InisUAP/mulita/Manual mulita  - MANUAL DE ARMADO - vd.pdf

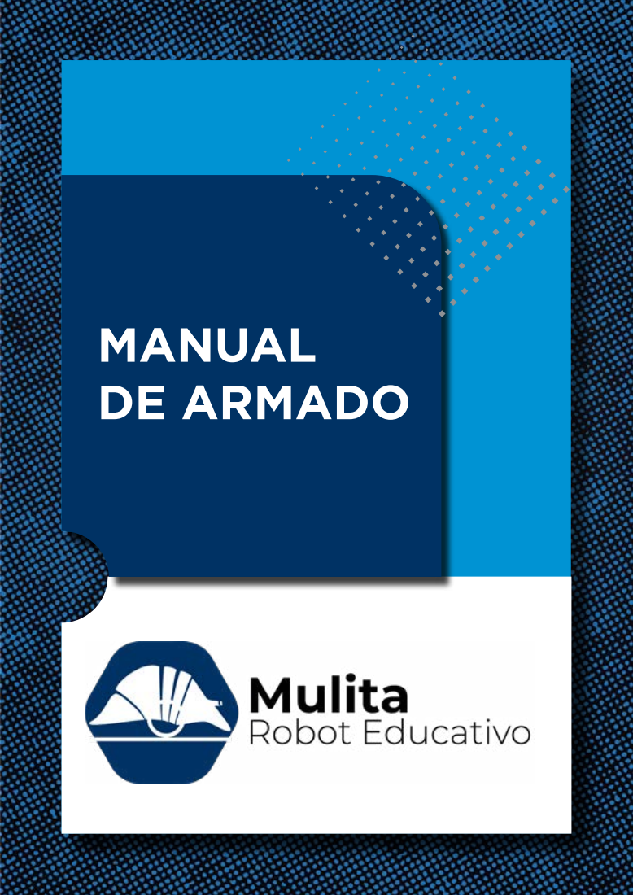
[picture p52: page 1]
MANUAL DE ARMADO

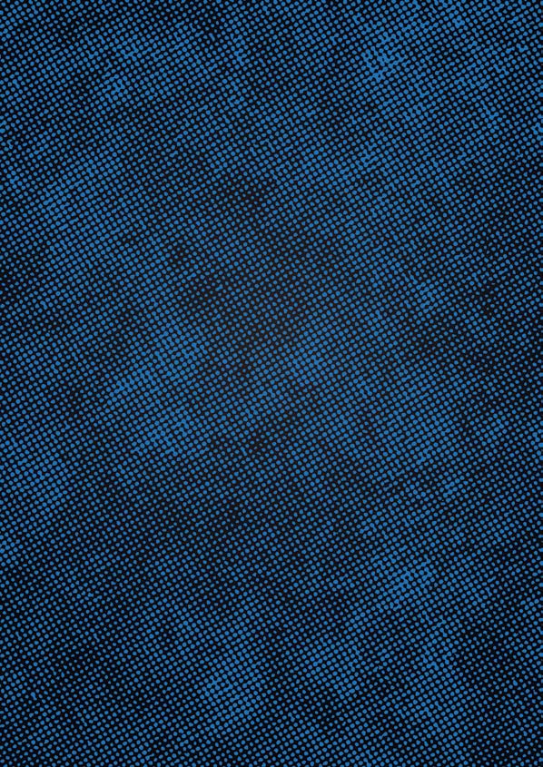
[picture p53: page 2]
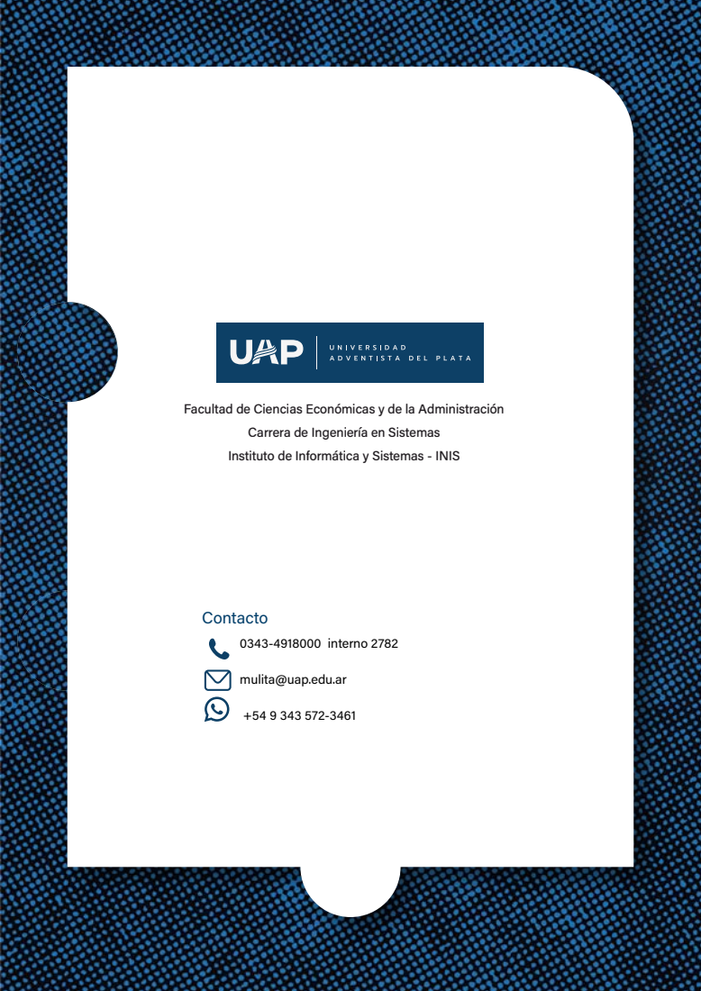
[picture p54: page 3]
0343-4918000 interno 2782; Contacto

Facultad de Ciencias Económicas y de la Administración

Carrera de Ingeniería en Sistemas

Instituto de Informática y Sistemas - INIS

mulita@uap.edu.ar

Autor: Sebastián Javier Calderón Diseño del manual: Mariel Mambretti Copyright y licencias
Mulita y logo de Mulita
Marcas/Trademarks
Atmel® and AVR® are registered trademarks or trademarks of Atmel Corporation or its subsidiaries, in theUS and/or other countries.
Arduino and Arduino UNO
Fritzing
miniBloq
Otros productos, nombres de firmas o empresas, marcas o brand names son marcas registradas o trademarks de sus respectivos propietarios. Cualquier omisión es no intencional.
Descargo de responsabilidad/Disclaimer:
La editorial y el autor hacen el mayor esfuerzo posible por garantizar la exactitud de la información presentada en este documento. Sin embargo, ni la editorial ni el autor se responsabilizan por los errores o las inexactitudes que pudieran aparecer. La información contenida en este documento está sujeta a cambios sin previo aviso. Todos los productos, marcas y nombres de firmas o empresas mencionados en este documento son propiedad exclusiva de sus respectivos propietarios. Cualquier omisión o error es absolutamente no intencional.
Este trabajo, el software o los elementos que eventualmente lo acompañen (sean estos de cualquier clase) son provistos por los dueños de los derechos intelectuales y por quienes contribuyeron a su desarrollo “como son”, renunciando ellos a cualquier tipo de garantía explícita o implícita, incluyendo, aunque no limitándose, a las garantías implícitas de comercialización y de adaptación a propósitos particulares. Bajo ninguna circunstancia serán los dueños de los derechos intelectuales y quienes contribuyeron al desarrollo responsables por daño alguno, directo, indirecto, incidental, casual, causal (incluyendo pero no limitándose a daños a la vida y/o a la propiedad, pérdida de datos, lucro cesante, interrupción de negocios), aunque este ocurra bajo cualquier teoría de derecho, producido en cualquier forma de uso de este desarrollo o desarrollos de él derivados, aun cuando se avise o no de dicho daño o su posibilidad.

# ÍNDICE

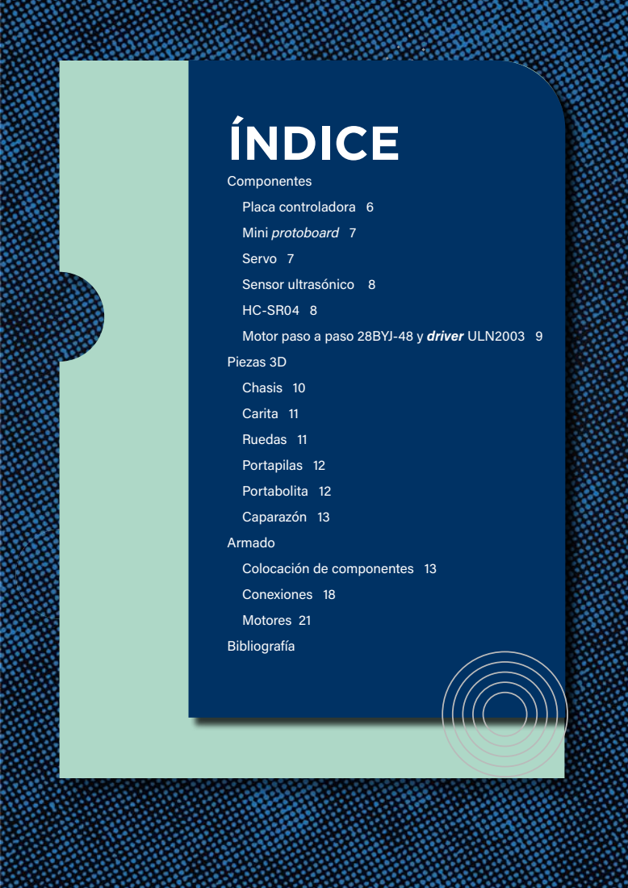
[picture p55: page 5]
Componentes Placa controladora 6 Mini protoboard 7 Servo 7 Sensor ultrasónico 8 HC-SR04 8 Motor paso a paso 28BYJ-48 y driver ULN2003 9 Piezas 3D Chasis 10 Carita 11 Ruedas 11 Portapilas 12 Portabolita 12 Caparazón 13 Armado Colocación de componentes 13 Conexiones 18 Motores 21 Bibliografía

Manual de armado Mulita

### La Mulita está conformada por cinco componentes básicos entre los que se encuentran la placa controladora, los motores y los sensores para la funcionalidad básica del

robot.

# COMPONENTES

La Mulita utiliza una placa controladora ArduinoUNO, que es la mejor placa para iniciar con la programación y la electrónica. Si es tu primera experiencia con la plataforma Arduino, la ArduinoUNO es la opción más robusta, más usada y con mayor cantidad de documentación de toda la familia Arduino.

# Placa controladora

Fuente: elaboración propia
6

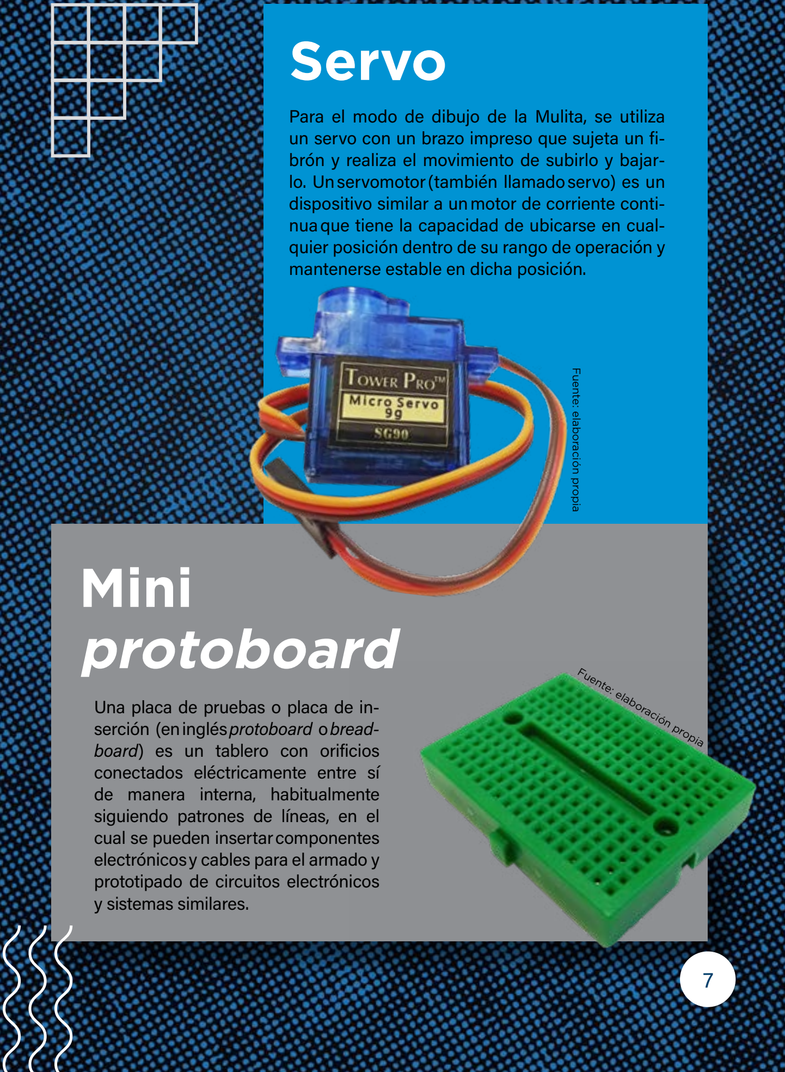
[picture p56: figure]
lo. Unservomotor(también llamadoservo) es un; mantenerse estable en dicha posición.; Servo; Una placa de pruebas o placa de in- serción (eninglésprotoboard obread- board) es un tablero con orificios conectados eléctricamente entre sí de manera interna, habitualmente siguiendo patrones de líneas, en el cual se pueden insertarcomponentes electrónicosy cables para el armado y prototipado de circuitos electrónicos y sistemas similares.; Mini

Para el modo de dibujo de la Mulita, se utiliza un servo con un brazo impreso que sujeta un fibrón y realiza el movimiento de subirlo y bajar-

dispositivo similar a unmotor de corriente continuaque tiene la capacidad de ubicarse en cualquier posición dentro de su rango de operación y

protoboard | Fuente: elaboración propia Fuente: elaboración propia

# Sensor ultrasónico

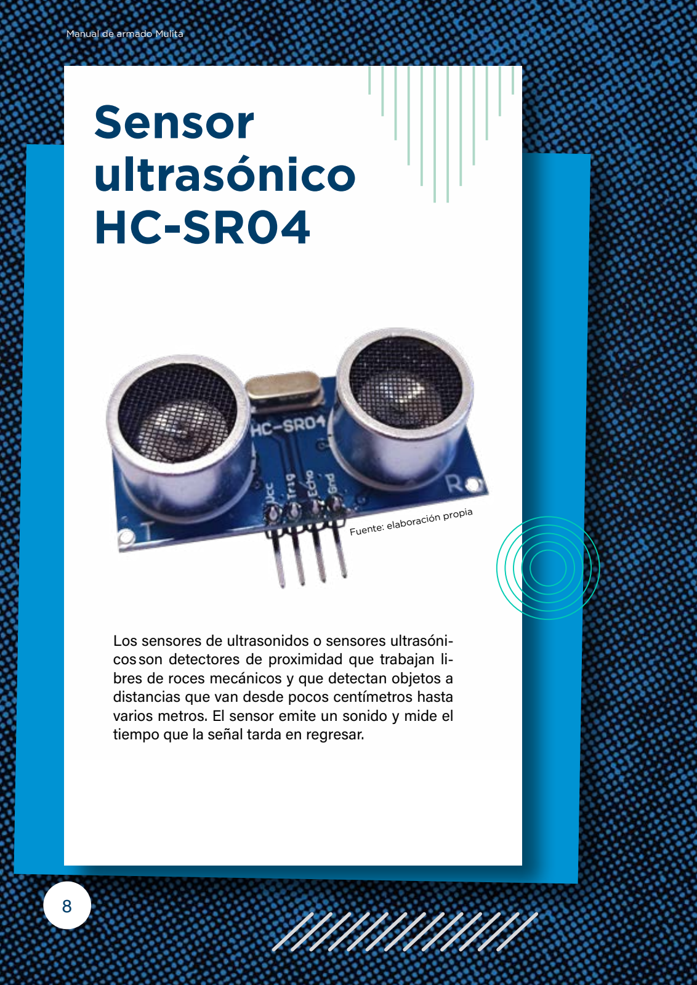
[picture p57: page 8]

Los sensores de ultrasonidos o sensores ultrasónicos son detectores de proximidad que trabajan libres de roces mecánicos y que detectan objetos a distancias que van desde pocos centímetros hasta varios metros. El sensor emite un sonido y mide el tiempo que la señal tarda en regresar.

Fuente: elaboración propia

# HC-SR04

8

# Motor paso a paso 28BYJ-48 y driver

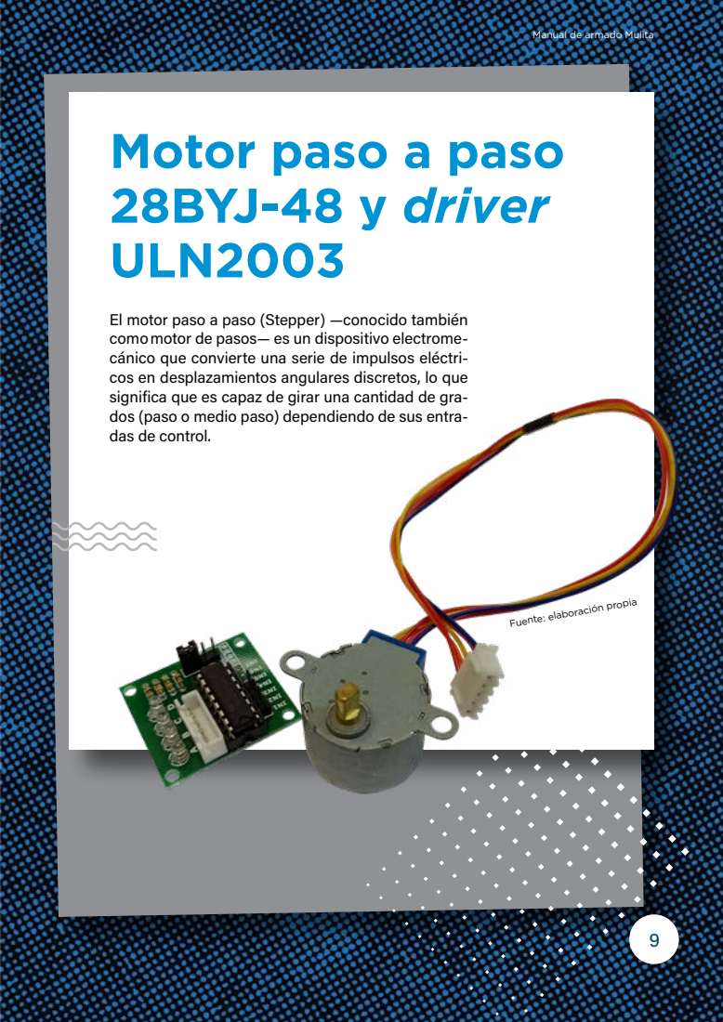
[picture p58: page 9]
ULN2003

El motor paso a paso (Stepper) —conocido también
comomotor de pasos— es un dispositivo electrome-
cánico que convierte una serie de impulsos eléctri-
cos en desplazamientos angulares discretos, lo que
significa que es capaz de girar una cantidad de gra-
dos (paso o medio paso) dependiendo de sus entra-
das de control.

Fuente: elaboración propia

# PIEZAS 3D

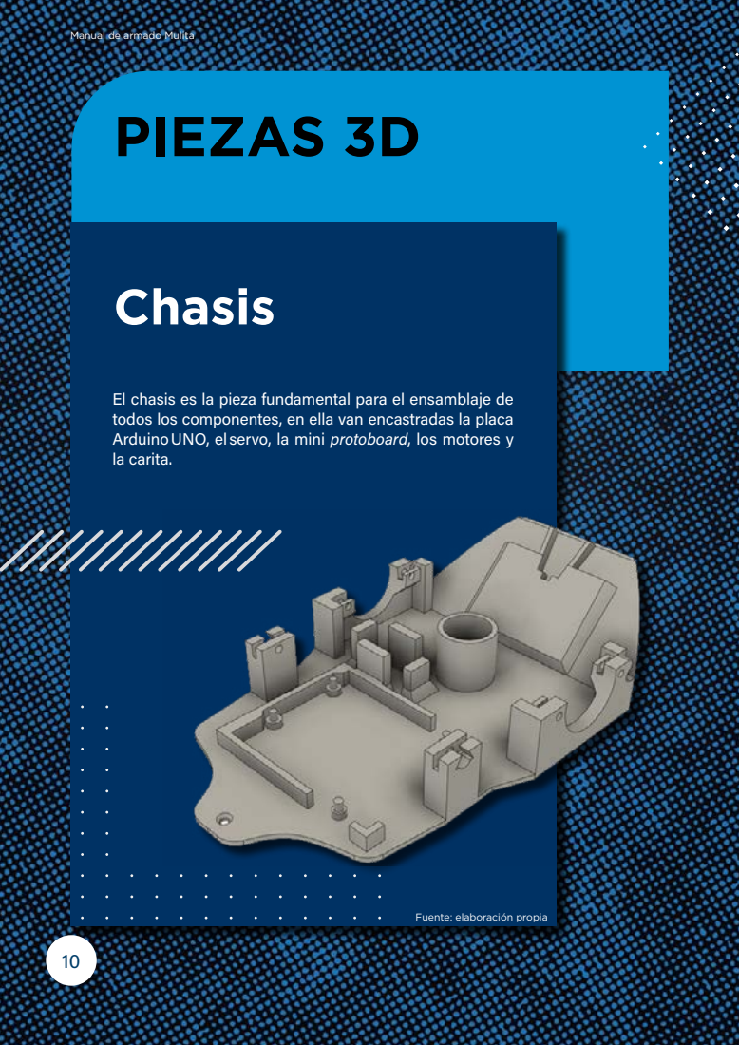
[picture p59: page 10]
Chasis

El chasis es la pieza fundamental para el ensamblaje de
todos los componentes, en ella van encastradas la placa
ArduinoUNO, el servo, la mini protoboard, los motores y
la carita.

Fuente: elaboración propia

# Ruedas

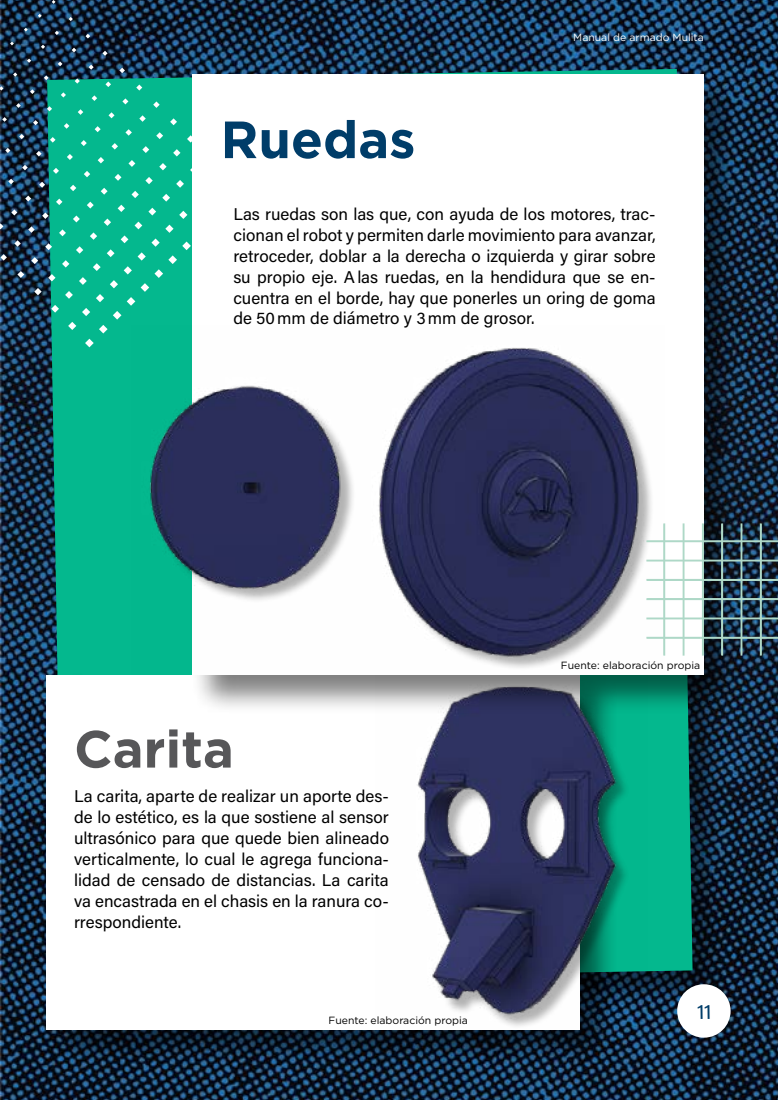
[picture p60: page 11]
Carita; Fuente: elaboración propia

Las ruedas son las que, con ayuda de los motores, trac-
cionan el robot y permiten darle movimiento para avanzar,
retroceder, doblar a la derecha o izquierda y girar sobre
su propio eje. Alas ruedas, en la hendidura que se en-
cuentra en el borde, hay que ponerles un oring de goma
de 50mm de diámetro y 3mm de grosor.

Fuente: elaboración propia

La carita, aparte de realizar un aporte des-
de lo estético, es la que sostiene al sensor
ultrasónico para que quede bien alineado
verticalmente, lo cual le agrega funciona-
lidad de censado de distancias. La carita
va encastrada en el chasis en la ranura co-
rrespondiente.

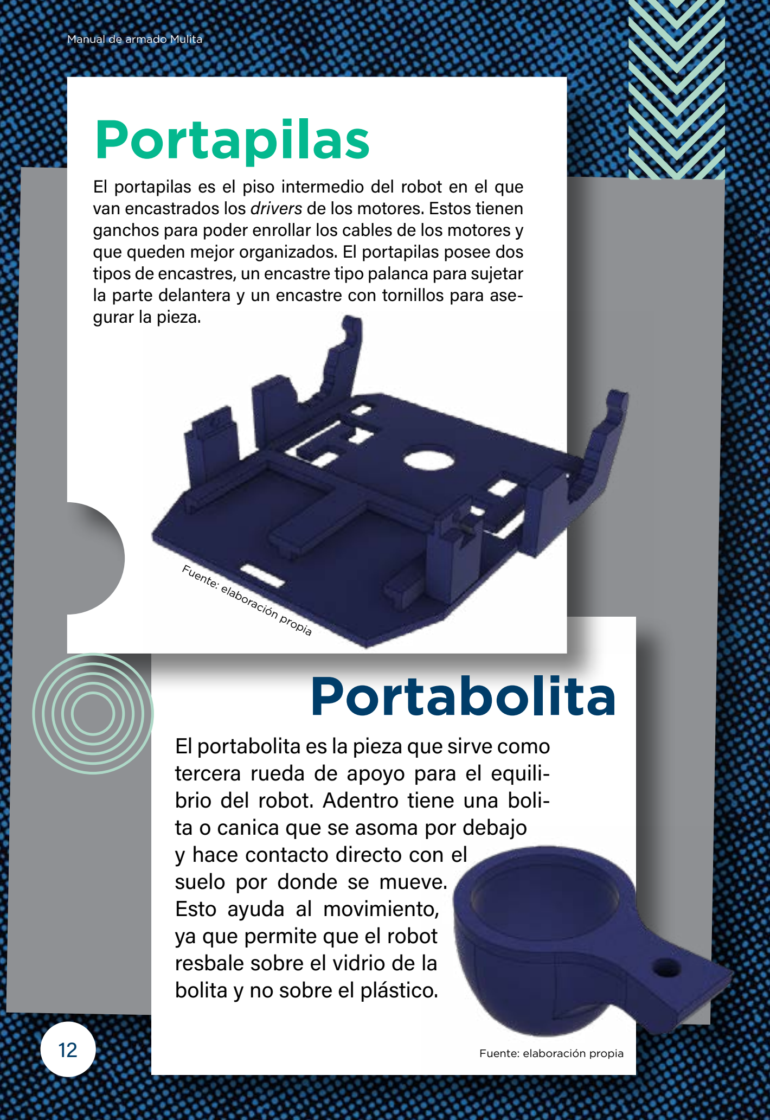
[picture p61: figure]
Portapilas; Fuente: elaboración propia; tercera rueda de apoyo para el equili- brio del robot. Adentro tiene una boli- ta o canica que se asoma por debajo y hace contacto directo con el suelo por donde se mueve. Esto ayuda al movimiento, ya que permite que el robot resbale sobre el vidrio de la bolita y no sobre el plástico.; Portabolita; gurar la pieza.

### El portabolita es la pieza que sirve como

El portapilas es el piso intermedio del robot en el que van encastrados los drivers de los motores. Estos tienen ganchos para poder enrollar los cables de los motores y que queden mejor organizados. El portapilas posee dos tipos de encastres, un encastre tipo palanca para sujetar la parte delantera y un encastre con tornillos para ase-

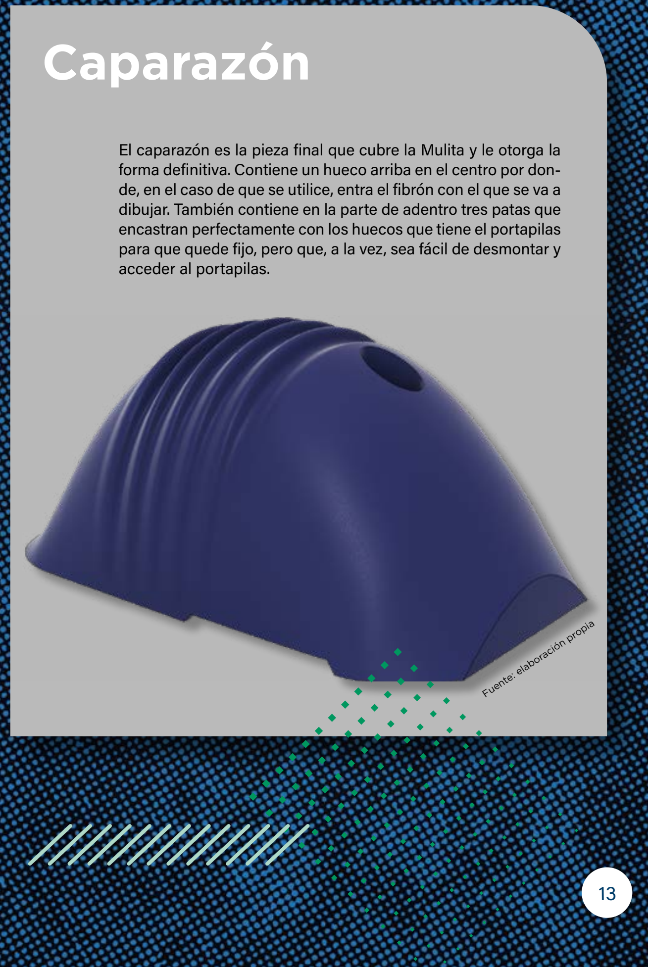
[picture p62: figure]
acceder al portapilas.; Caparazón; Fuente: elaboración propia

El caparazón es la pieza final que cubre la Mulita y le otorga la forma definitiva. Contiene un hueco arriba en el centro por donde, en el caso de que se utilice, entra el fibrón con el que se va a dibujar. También contiene en la parte de adentro tres patas que encastran perfectamente con los huecos que tiene el portapilas para que quede fijo, pero que, a la vez, sea fácil de desmontar y

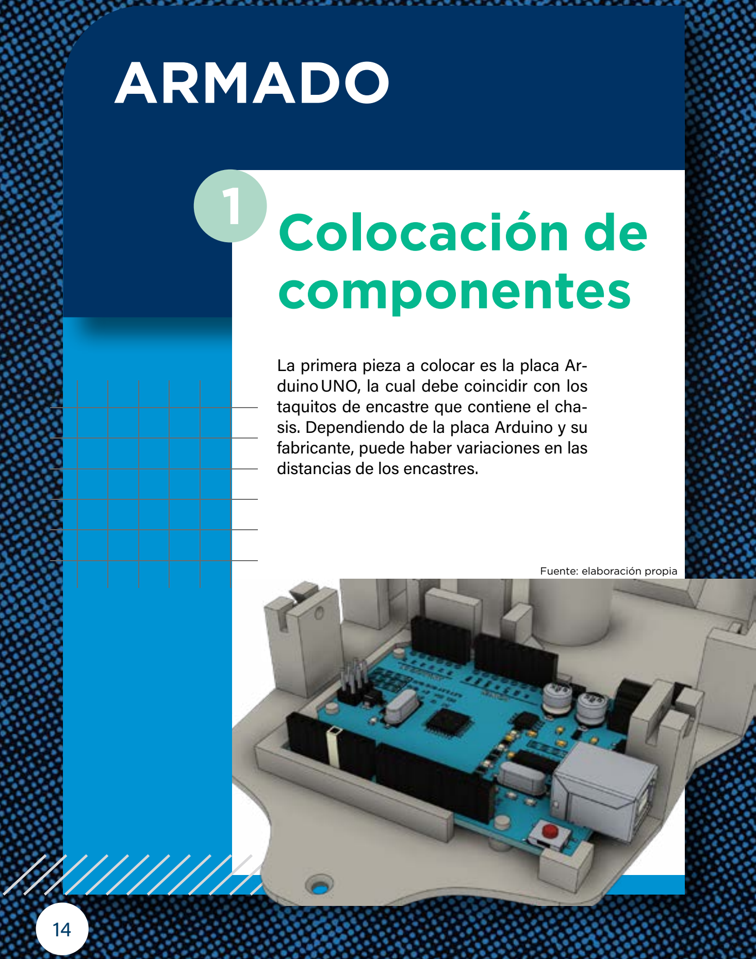
[picture p63: figure]
ARMADO; Colocación de componentes; distancias de los encastres.; Fuente: elaboración propia

La primera pieza a colocar es la placa ArduinoUNO, la cual debe coincidir con los taquitos de encastre que contiene el chasis. Dependiendo de la placa Arduino y su fabricante, puede haber variaciones en las

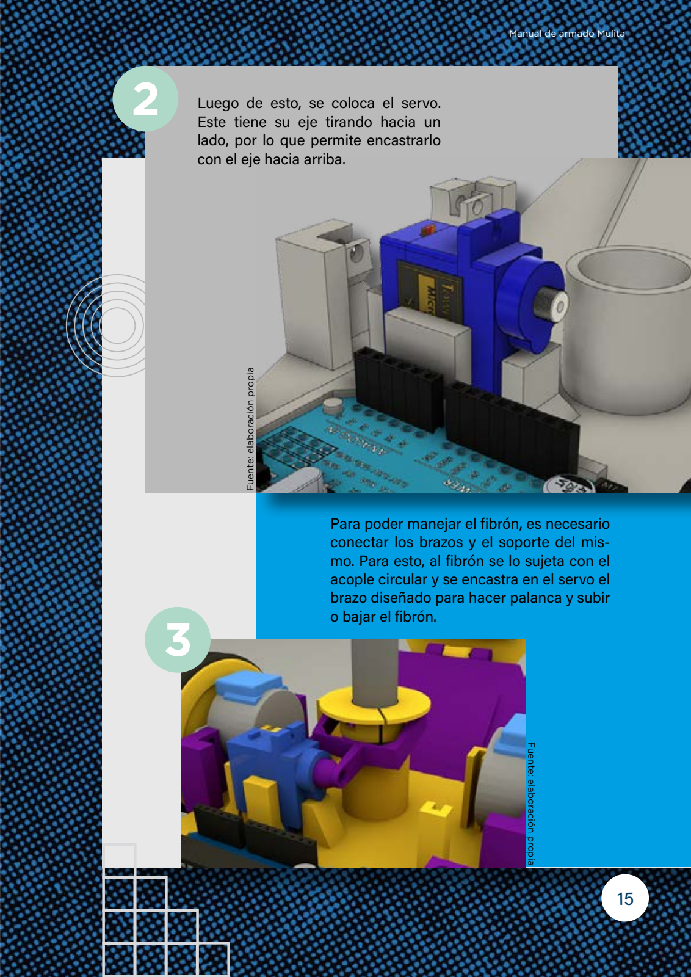
[picture p64: page 15]

Luego de esto, se coloca el servo. Este tiene su eje tirando hacia un lado, por lo que permite encastrarlo con el eje hacia arriba.

Para poder manejar el fibrón, es necesario conectar los brazos y el soporte del mismo. Para esto, al fibrón se lo sujeta con el acople circular y se encastra en el servo el brazo diseñado para hacer palanca y subir o bajar el fibrón.

Fuente: elaboración propia

Fuente: elaboración propia

15

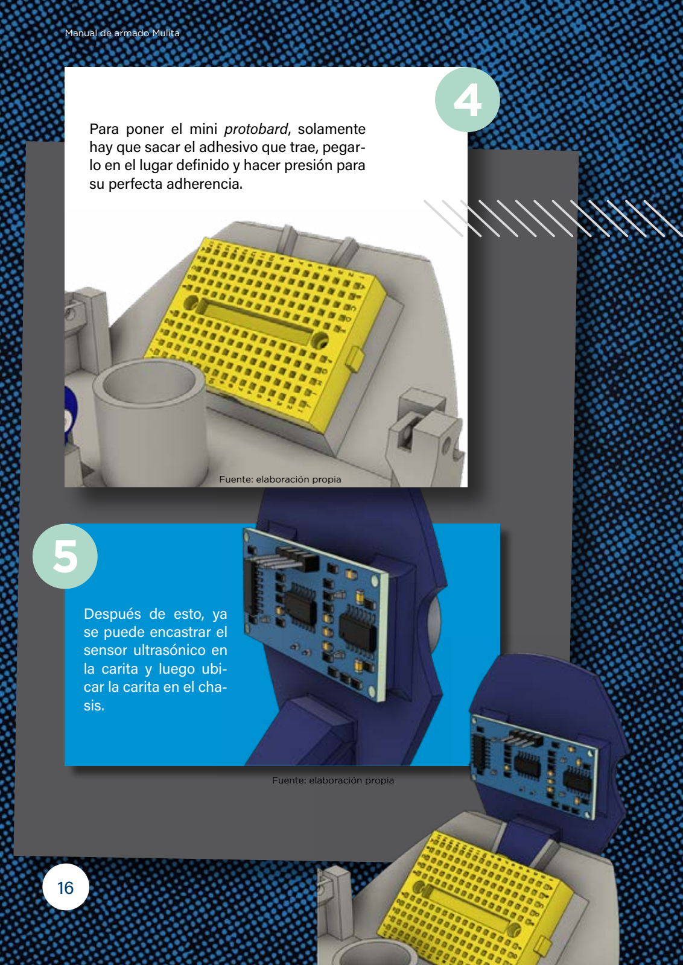
[picture p65: page 16]

Después de esto, ya
se puede encastrar el
sensor ultrasónico en
la carita y luego ubicar la carita en el chasis.

Para poner el mini protobard, solamente hay que sacar el adhesivo que trae, pegarlo en el lugar definido y hacer presión para su perfecta adherencia.

Fuente: elaboración propia

Fuente: elaboración propia

16

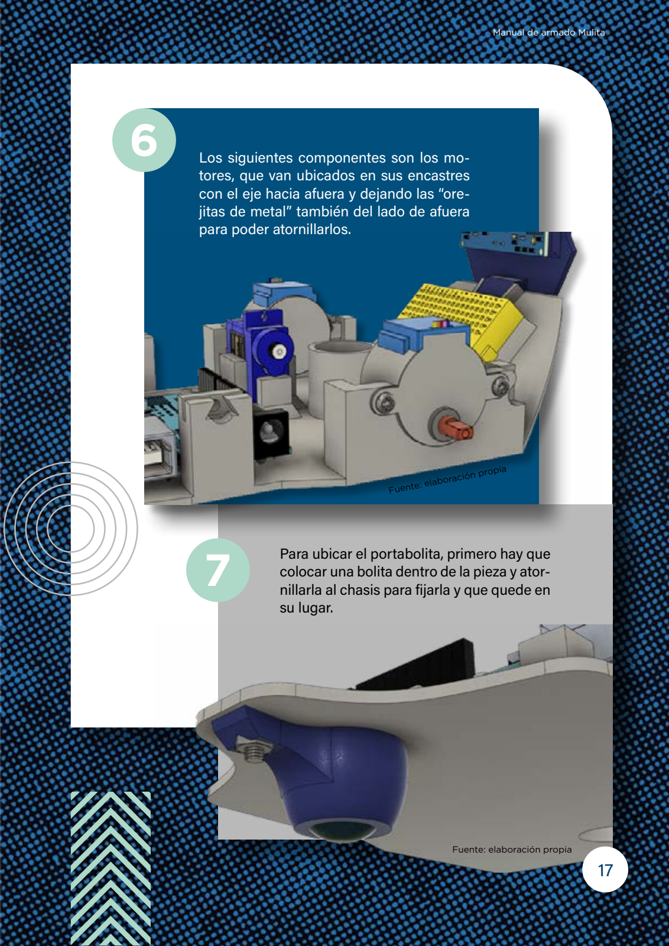
[picture p66: page 17]

Para ubicar el portabolita, primero hay que colocar una bolita dentro de la pieza y atornillarla al chasis para fijarla y que quede en su lugar.

Los siguientes componentes son los motores, que van ubicados en sus encastres con el eje hacia afuera y dejando las “orejitas de metal” también del lado de afuera para poder atornillarlos.

Fuente: elaboración propia

Fuente: elaboración propia
17

# Conexiones

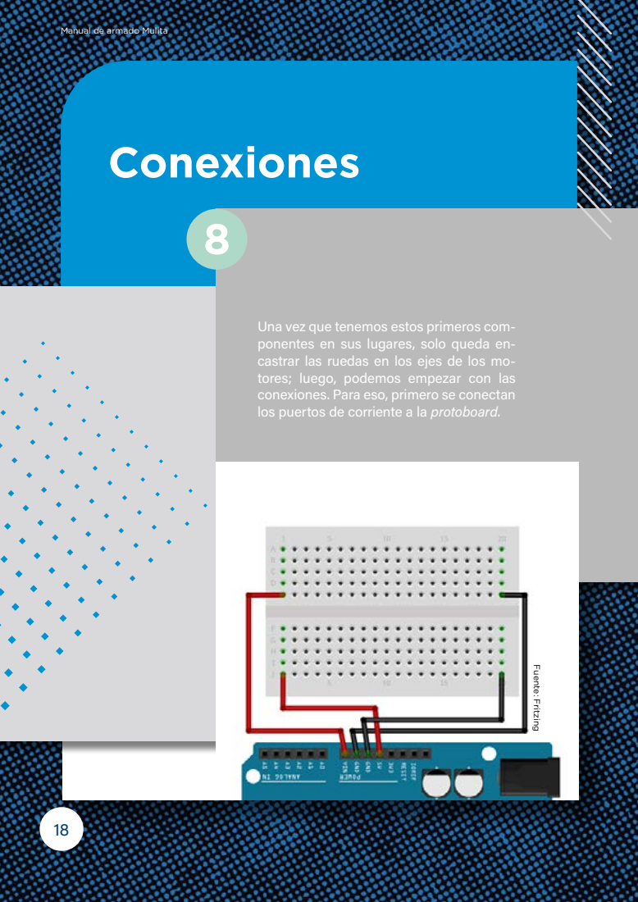
[picture p67: page 18]
ponentes en; sus lugares, solo queda en-; Fuente: Fritzing

Una vez que tenemos estos primeros com-
castrar las ruedas en los ejes de los mo-tores; luego, | podemos empezar con las
conexiones. Para eso, primero se conectan los puertos de corriente a la protoboard.

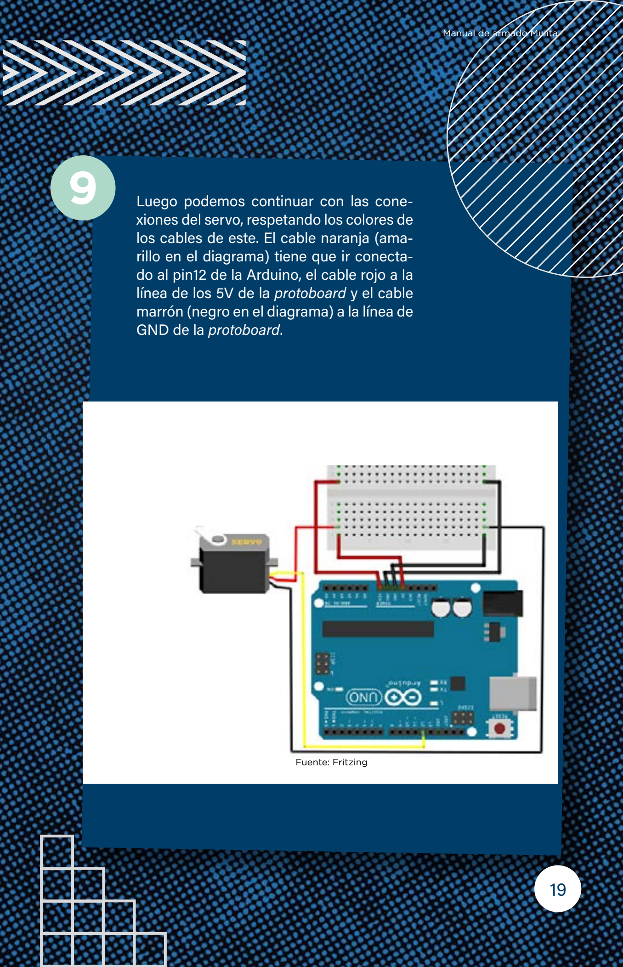
[picture p68: figure]
Luego podemos continuar con las cone-; GND de la protoboard.; Fuente: Fritzing

xiones del servo, respetando los colores de los cables de este. El cable naranja (amarillo en el diagrama) tiene que ir conectado al pin12 de la Arduino, el cable rojo a la línea de los 5V de la protoboard y el cable marrón (negro en el diagrama) a la línea de

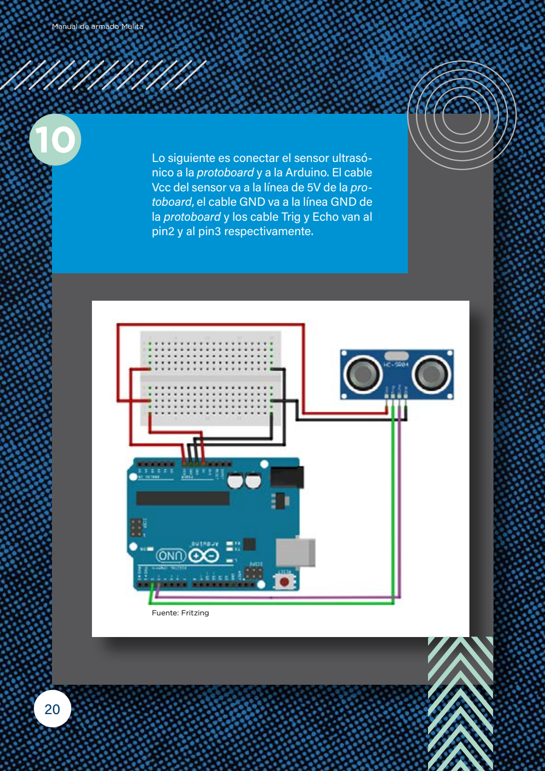
[picture p69: page 20]

Lo siguiente es conectar el sensor ultrasónico a la protoboard y a la Arduino. El cable Vcc del sensor va a la línea de 5V de la protoboard, el cable GND va a la línea GND de la protoboard y los cable Trig y Echo van al pin2 y al pin3 respectivamente.

Fuente: Fritzing

20

# Motores

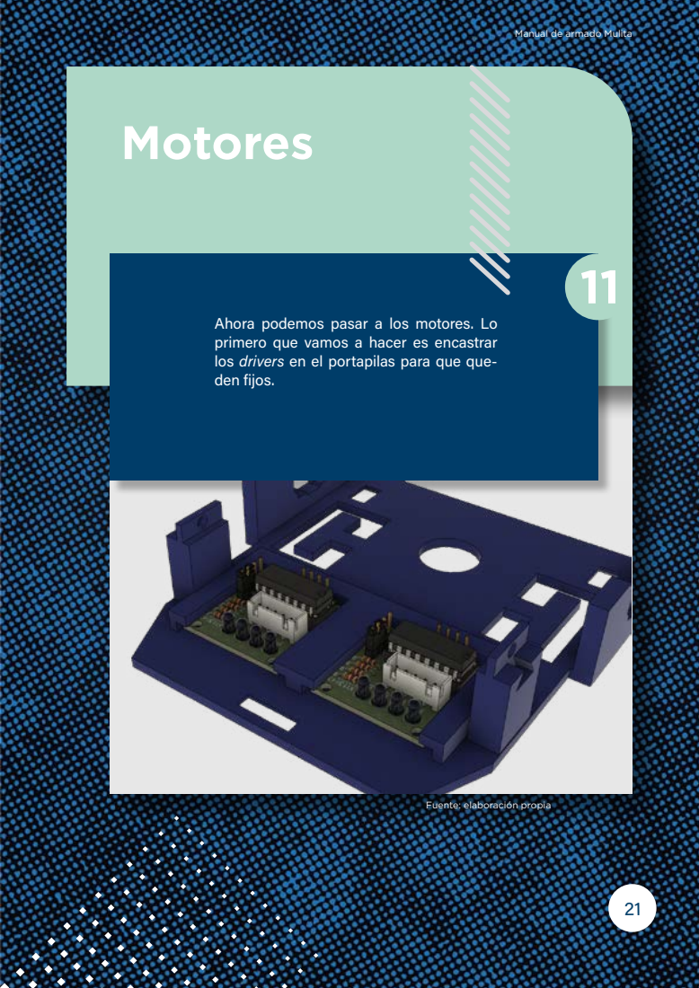
[picture p70: page 21]

Ahora podemos pasar a los motores. Lo primero que vamos a hacer es encastrar los drivers en el portapilas para que que-den fijos.

Fuente: elaboración propia

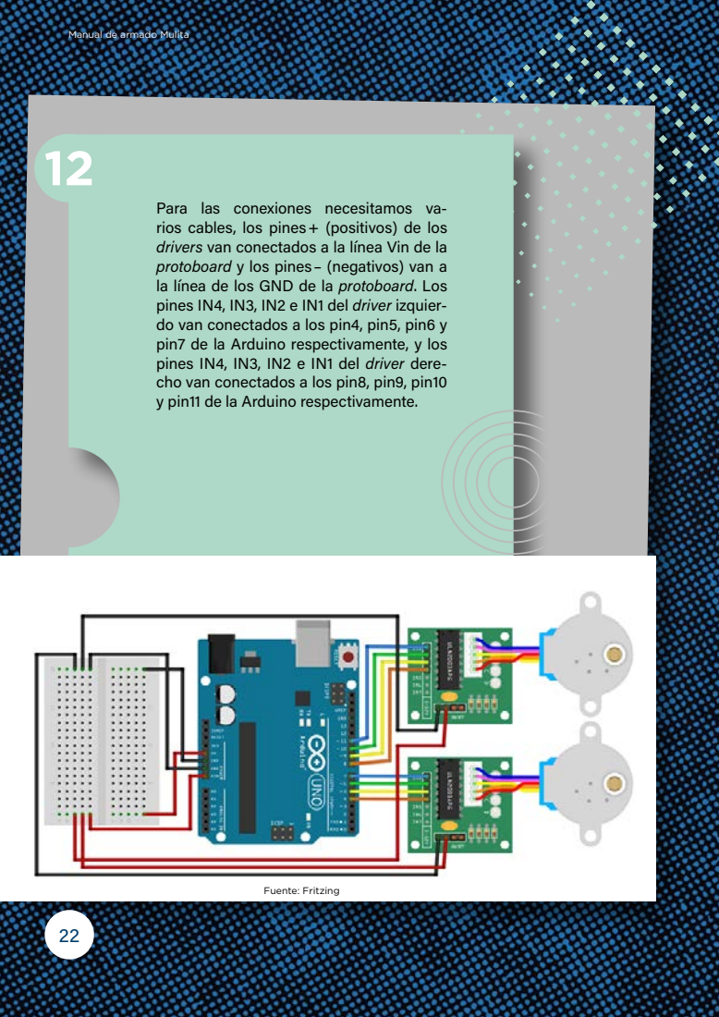
[picture p71: page 22]
Fuente: Fritzing

Para las conexiones necesitamos va-
rios cables, los pines+ (positivos) de los
drivers van conectados a la línea Vin de la
protoboard y los pines– (negativos) van a
la línea de los GND de la protoboard. Los
pines IN4, IN3, IN2 e IN1 del driver izquier-
do van conectados a los pin4, pin5, pin6 y
pin7 de la Arduino respectivamente, y los
pines IN4, IN3, IN2 e IN1 del driver dere-
cho van conectados a los pin8, pin9, pin10
y pin11 de la Arduino respectivamente.

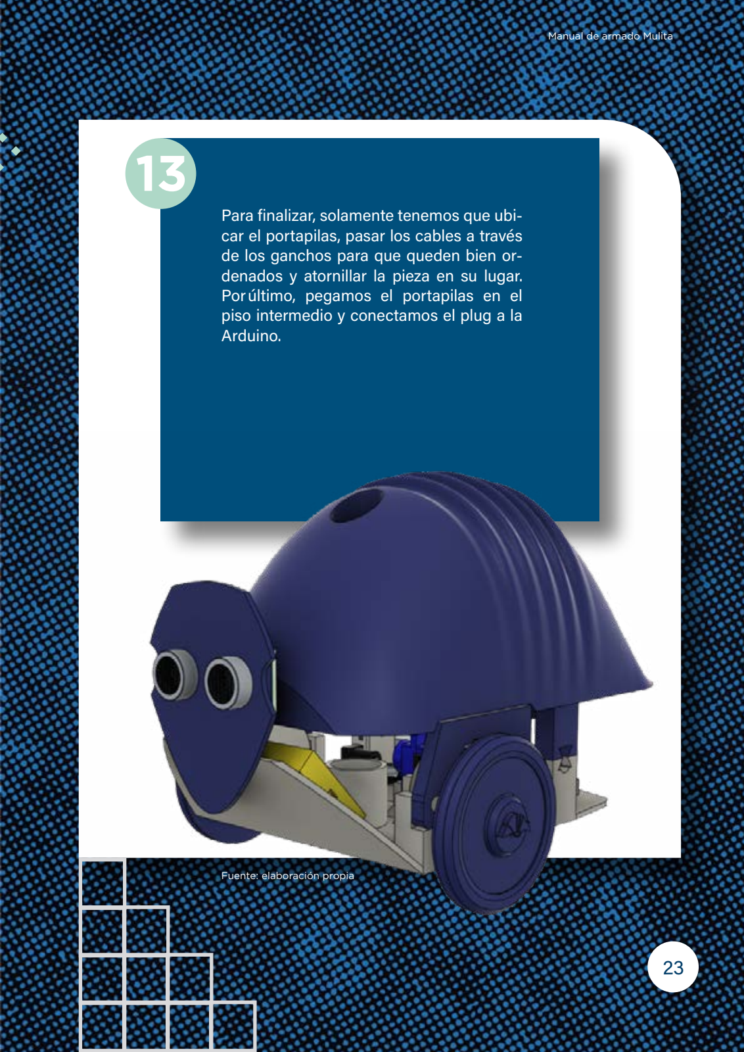
[picture p72: page 23]

Para finalizar, solamente tenemos que ubicar el portapilas, pasar los cables a través de los ganchos para que queden bien ordenados y atornillar la pieza en su lugar. Porúltimo, pegamos el portapilas en el piso intermedio y conectamos el plug a la Arduino.

Fuente: elaboración propia

23

# BIBLIOGRAFÍA

Wikipedia, “Arduino”. Disponible en: https://es.wikipedia.org/wiki/Arduino, (https://es.wikipedia.org/wiki/Arduino) accedido el 10 de junio de 2022. Wikipedia, “Servomotor”. Disponible en: https://es.wikipedia.org/wiki/Servomotor, (https://es.wikipedia.org/wiki/Servomotor) accedido el 10 de junio de 2022. Wikipedia, “Placa de pruebas”. Disponible en: https://es.wikipedia.org/wiki/Placa_de_pruebas, (https://es.wikipedia.org/wiki/Placa_de_pruebas) accedido el 10 de junio de 2022. Wikipedia, “Sensor ultrasónico”. Disponible en: https://es.wikipedia.org/wiki/Sensor_ultras%C3%B3nico, (https://es.wikipedia.org/wiki/Sensor_ultras%C3%B3nico) accedido el 10 de junio de 2022. Wikipedia, “Motor paso a paso”. Disponible en: https://es.wikipedia.org/wiki/Motor_paso_a_paso, (https://es.wikipedia.org/wiki/Motor_paso_a_paso) accedido el 10 de junio de 2022.
