InisUAP/mulita/(commit log)

2019-06-12 codigos y libreria
    subida de libreria y codigo de ejemplo
2019-06-12 descripcion
    descripcion de la mulita
2019-06-21 actualizacion thingiverse
    añadido el link de thigiverse
2019-06-21 esquema electronica
    actualización con esquema de electronica
2024-10-16 Add files via upload
    Manual de armado
2024-10-16 Add files via upload
    guia de actividades
